HalFrgrd/slickbug/hardware/production/bom.csv

Designator | Footprint | Quantity | Value | LCSC Part #
C1 | C_0603 | 1 | 1uF | C15849
F1 | F0805 | 1 | JK-SMD0805-020-30V | C516070
R1, R2 | R_0603 | 2 | 33Ω | C23140
U4 | SOT-23-5_L3.0-W1.6-P0.95-LS2.8-BR | 1 | MAX40203AUK+T | C2653639
