HalFrgrd/slickbug/hardware/slick_bug.kicad_pcb

## KiCad design hardware/slick_bug.kicad_pcb (2026-10-18)

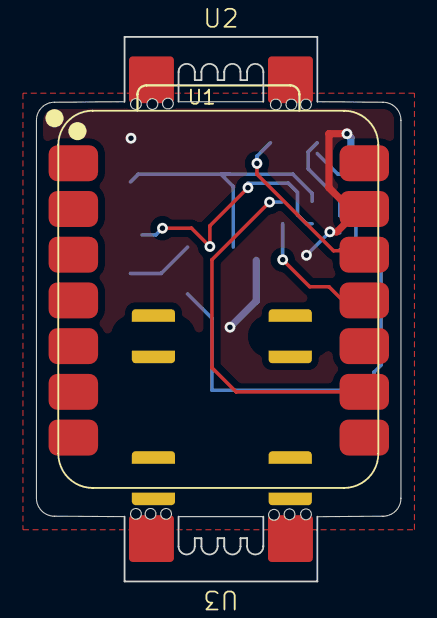
[picture p9: board slick_bug.kicad_pcb from above]

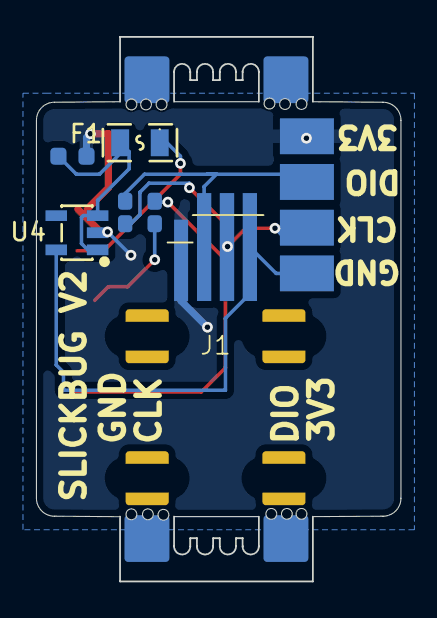
[picture p10: board slick_bug.kicad_pcb from below]

Board: 2 copper layers, 20.2 x 30.3 mm, 10 parts (7 on the bottom side), 8 nets.

Parts:
C1: 1uF; C_0603
F1: JK-SMD0805-020-30V; F0805
J1: Conn_01x04_Socket; R50_horizontal_4pin
J2: Conn_01x04_Socket; Harwin_M20-89004xx_1x04_P2.54mm_Horizontal_blank
R1, R2: 33Ω; R_0603
U1: XIAO-RP2040-SMD
U2, U3: R50_pcb_comb
U4: MAX40203AUK+T; SOT-23-5_L3.0-W1.6-P0.95-LS2.8-BR

Connections:
GND: C1.2, J1.1, J2.1, U1.13 (GND), U4.2 (GND)
unnamed: F1.1, U1.12 (3V3_OUT)
unnamed: R2.1, U1.9 (D8)
unnamed: R1.1, U1.11 (D10)
unnamed: C1.1, F1.2, U4.1 (VDD), U4.3 (EN)
TARGET_SWCLK: J1.2, J2.2, R2.2
TARGET_SWDIO: J1.3, J2.3, R1.2
TARGET_VCC: J1.4, J2.4, U4.5 (OUT)
