HalFrgrd/slickbug/(commit log)

2026-08-27 kicad_assets submodule
2026-08-27 pin order change
2026-09-26 pico sdk
2026-10-18 update kicad assets
