HalFrgrd/slickbug/assets/slickbug_v1_bottom.jpg

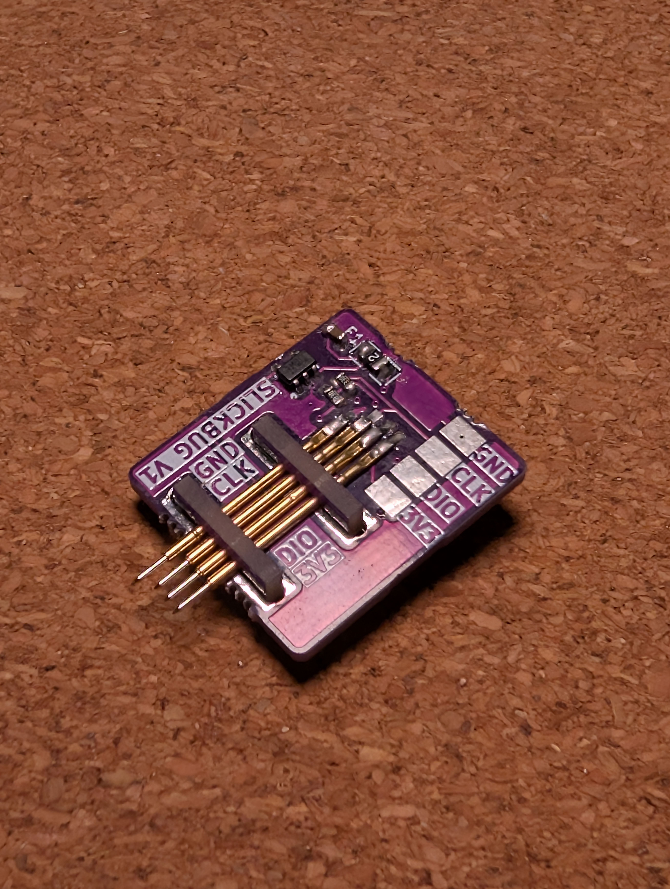
[picture p1: assets/slickbug_v1_bottom.jpg]
assets/slickbug_v1_bottom.jpg
