HalFrgrd/slickbug/assets/slickbug_v1_top.jpg

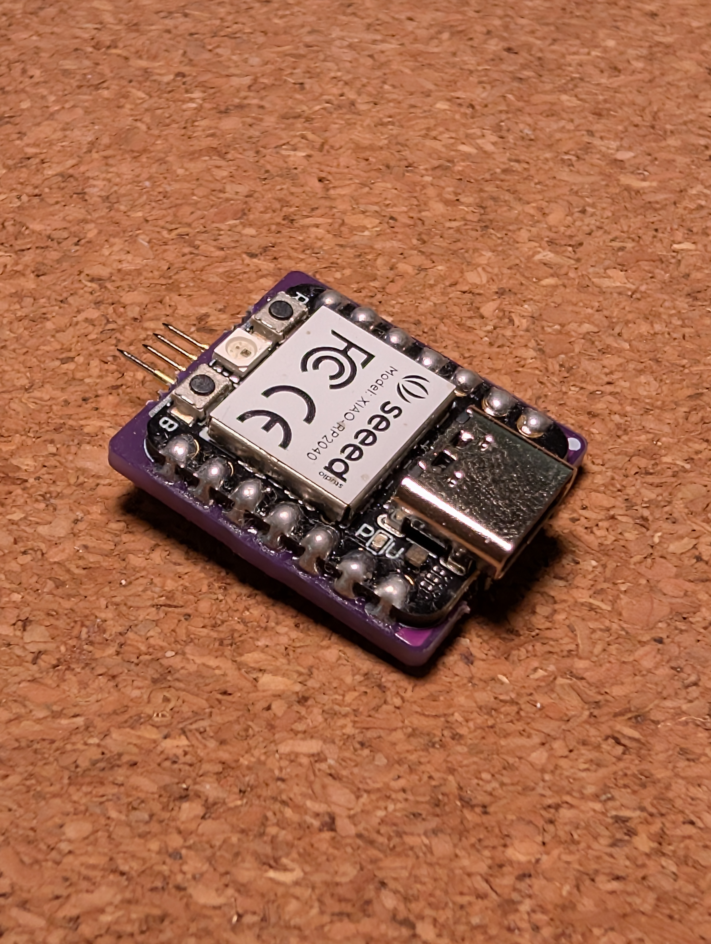
[picture p2: assets/slickbug_v1_top.jpg]
assets/slickbug_v1_top.jpg
